morena1001/Midi-Controller/Documentation/Task Decomposition.md

## Task Decomposition

- [x] ~~Prototype on prototyping MCU~~
  - [x] ~~Setup IDE project for the prototyping MCU~~
    - [x] ~~GPIO input and ADC pins~~
    - [x] ~~USB pins~~
  - [x] ~~Setup push button layout on prototyping breadboard~~
  - [x] ~~Connect breadboard and components to the MCU~~
  - [x] ~~Setup USB connection using custom usb cable~~
  - [x] ~~Write code to transmit MIDI messages~~

- [x] ~~Prototype on final design MCU~~
  - [x] ~~Setup new IDE project using the final design MCU~~
  - [x] ~~Rewire breaboard and components to the final design MCU~~
  - [x] ~~Setup USB connection using Micro USB to USB A cable~~
  - [x] ~~Translate code to work with final design MCU~~

- [x] Design final product part 1
  - [x] Choose components for the project
    - [x] ~~push buttons~~
    - [x] ~~potentiometers~~
    - [ ] capacitors (breadboard and SMD)
    - [ ] LED (SMD) ? 
  - [x] Design PCB according to the size and pin specifications of all the components
    - [x] Send schematics to be printed by a 3rd party PCB printing company online
  - [x] Create rough sketch of the layout for the push buttons and potentiometers

- [x] Prototype on final design components
  - [x] Fix issues and bugs software side before testing the PCB (6 29 25)
  - [x] Rewire breadboard to test final design push buttons, potentiometers, and capacitor
  - [x] Solder final design push buttons, capacitors, potentiometers, and MCU to the 3rd party PCB
  - [x] Test to make sure PCB and components are working as should

- [ ] Design final product part 2
  - [x] Dimension the PCB and its will-be-visible components 
  - [x] Create rough sketch of case
  - [ ] Print the case
    - [x] First half is the top part with the holes for the push buttons, potentiometers, and Micro USB port
    - [x] Bottom half is a solid plate
    - [ ] Halves are connected via screws
    - [ ] Reiterate until dimensions are good

- [ ] Assemble final design
  - [ ] Attach PCB inside the case
  - [ ] Close the case and attach external components
    - [ ] Friction pad to prevent sliding
    - [ ] Clear plastic to view led ?

- [x] Final live test
  - [x] Do final test to make sure all works well
  - [x] Do a live test with entire setup at church
