morena1001/Midi-Controller/pcb/pcb.step

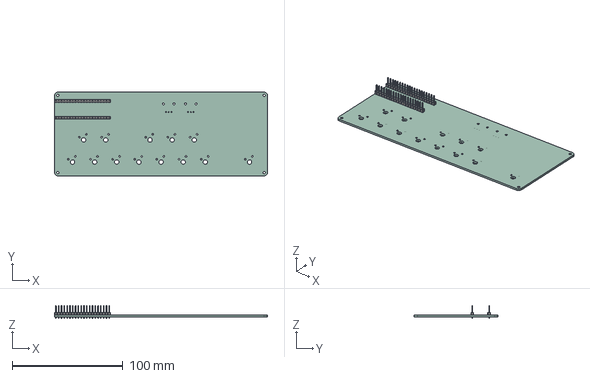
[picture p1: CAD file, 2025-06-20]
pcb/pcb.step
192.5 x 75.8 x 11.5 mm
PinHeader_1x20_P254mm_Vertical x 2
pcb_PCB
