morena1001/Midi-Controller/(list of files, cad)

Other CAD files:
pcb/pcb.3mf
