morena1001/Midi-Controller/pcb/pcb.kicad_pcb

## KiCad design pcb/pcb.kicad_pcb (2025-06-18)

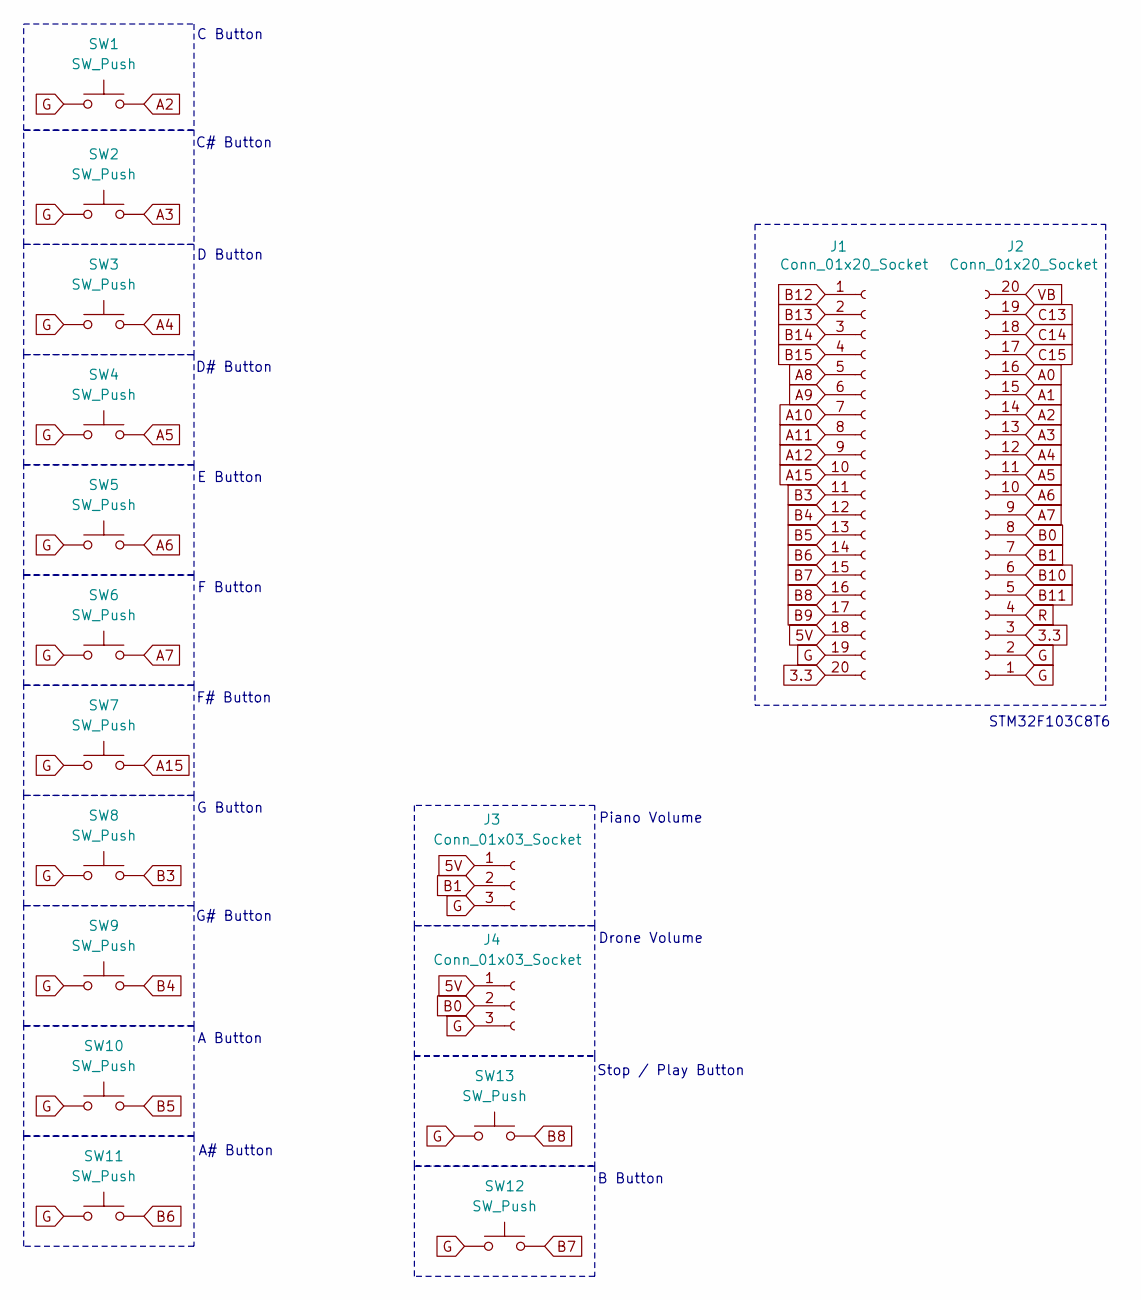
[picture p2: schematic pcb.kicad_sch]

Parts:
J1, J2: Conn_01x20_Socket; PinHeader_1x20_P2.54mm_Vertical
J3, J4: Conn_01x03_Socket; Potentiometer_Alpha_RD901F-40-00D_Single_Vertical_CircularH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
SW1, SW2, SW3, SW4, SW5, SW6, SW7, SW8, SW9, SW10, SW11, SW12, SW13: SW_Push; SW_Cherry_MX_1.00u_Plate

Connections:
3.3: J1.20, J2.3
5V: J1.18, J3.1, J4.1
A0: J2.16
A1: J2.15
A2: J2.14, SW1.2
A3: J2.13, SW2.2
A4: J2.12, SW3.2
A5: J2.11, SW4.2
A6: J2.10, SW5.2
A7: J2.9, SW6.2
A8: J1.5
A9: J1.6
A10: J1.7
A11: J1.8
A12: J1.9
A15: J1.10, SW7.2
B0: J2.8, J4.2
B1: J2.7, J3.2
B3: J1.11, SW8.2
B4: J1.12, SW9.2
B5: J1.13, SW10.2
B6: J1.14, SW11.2
B7: J1.15, SW12.2
B8: J1.16, SW13.2
B9: J1.17
B10: J2.6
B11: J2.5
B12: J1.1
B13: J1.2
B14: J1.3
B15: J1.4
C13: J2.19
C14: J2.18
C15: J2.17
G: J1.19, J2.1, J2.2, J3.3, J4.3, SW1.1, SW2.1, SW3.1, SW4.1, SW5.1, SW6.1, SW7.1, SW8.1, SW9.1, SW10.1, SW11.1, SW12.1, SW13.1
R: J2.4
VB: J2.20

Notes on the sheet:
G Button
B Button
Stop / Play Button
F Button
F# Button
C# Button
A# Button
C Button
Drone Volume
G# Button
D# Button
A Button
Piano Volume
D Button
STM32F103C8T6
E Button

Board: 2 copper layers, 17 parts (0 on the bottom side), 18 nets, no tracks yet.
