morena1001/Midi-Controller/Core/Src/main.c

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
/* Includes ------------------------------------------------------------------*/
#include "main.h"
#include "usb_device.h"

/* USER CODE BEGIN Includes */
#include "usbd_midi.h"
#include "queue.h"
/* USER CODE END Includes */

ADC_HandleTypeDef hadc1;
ADC_HandleTypeDef hadc2;

TIM_HandleTypeDef htim2;
TIM_HandleTypeDef htim3;

/* USER CODE BEGIN PV */
extern USBD_HandleTypeDef hUsbDeviceFS;

extern uint16_t D_previous;
extern uint16_t D_current;
extern uint16_t D_sum;

extern uint16_t P_previous;
extern uint16_t P_current;
extern uint16_t P_sum;

extern uint8_t D_vol_message [4];
extern uint8_t P_vol_message [4];
/* USER CODE END PV */

void SystemClock_Config(void);
static void MX_GPIO_Init(void);
static void MX_ADC1_Init(void);
static void MX_TIM2_Init(void);
static void MX_ADC2_Init(void);
static void MX_TIM3_Init(void);
/* USER CODE BEGIN PFP */
uint16_t ADC_Convert_Rank1 (void);
uint16_t ADC_Convert_Rank2 (void);
/* USER CODE END PFP */

/* USER CODE BEGIN 0 */
uint16_t ADC_Convert_Rank1 (void) {
	ADC_ChannelConfTypeDef sConfig = {0};

	sConfig.Channel = ADC_CHANNEL_8;
	sConfig.Rank = ADC_REGULAR_RANK_1;
	sConfig.SamplingTime = ADC_SAMPLETIME_1CYCLE_5;
	if (HAL_ADC_ConfigChannel(&hadc1, &sConfig) != HAL_OK)
	{
		Error_Handler();
	}

	HAL_ADC_Start (&hadc1);
	HAL_ADC_PollForConversion (&hadc1, 100);
	uint16_t val = HAL_ADC_GetValue (&hadc1);
	HAL_ADC_Stop (&hadc1);

	return val;
}

uint16_t ADC_Convert_Rank2 (void) {
	ADC_ChannelConfTypeDef sConfig = {0};

	sConfig.Channel = ADC_CHANNEL_9; // ADC_CHANNEL_0
 	sConfig.Rank = ADC_REGULAR_RANK_1;
	sConfig.SamplingTime = ADC_SAMPLETIME_1CYCLE_5;
	if (HAL_ADC_ConfigChannel(&hadc2 /*&hadc1*/, &sConfig) != HAL_OK)
	{
		Error_Handler();
	}

	HAL_ADC_Start (&hadc2 /*&hadc1*/);
	HAL_ADC_PollForConversion (&hadc2 /*&hadc1*/, 100);
	uint16_t val = HAL_ADC_GetValue (&hadc2 /*&hadc1*/);
	HAL_ADC_Stop (&hadc2 /*&hadc1*/);

	return val;
}
/* USER CODE END 0 */

/**
  * @brief  The application entry point.
  * @retval int
  */
int main(void)
{

  /* MCU Configuration--------------------------------------------------------*/

  /* Reset of all peripherals, Initializes the Flash interface and the Systick. */
  HAL_Init();

  /* Configure the system clock */
  SystemClock_Config();

  /* Initialize all configured peripherals */
  MX_GPIO_Init();
  MX_USB_DEVICE_Init();
  MX_ADC1_Init();
  MX_TIM2_Init();
  MX_ADC2_Init();
  MX_TIM3_Init();
  /* USER CODE BEGIN 2 */
  Queue_Init (DEFAULT_QUEUE_SIZE);

//	for (uint8_t i = 0; i < 16; i++)	D_sum += ADC_Convert_Rank1 ();
//
//	D_current = ((D_sum >> 4) * 127) / 4095;
//	D_sum = 0;
//
//	if (D_current < D_previous - 3 || D_current > D_previous + 3) {
//		D_previous = D_current;
//		D_vol_message [3] = D_current;
//
//	//		while (USBD_MIDI_GetState (&hUsbDeviceFS) != MIDI_IDLE) {}
//		USBD_MIDI_SendPackets (&hUsbDeviceFS, D_vol_message, 4);
//	//		Enqueue (D_vol_message);
//	}
//
//	for (uint8_t i = 0; i < 16; i++)	P_sum += ADC_Convert_Rank2 ();
//
//	P_current = ((P_sum >> 4) * 127) / 4095;
//	P_sum = 0;
//
//	if (P_current < P_previous - 3 || P_current > P_previous + 3) {
//		P_previous = P_current;
//		D_vol_message [3] = P_current;
//
//	//		while (USBD_MIDI_GetState (&hUsbDeviceFS) != MIDI_IDLE) {}
//		USBD_MIDI_SendPackets (&hUsbDeviceFS, P_vol_message, 4);
//	//		Enqueue (P_vol_message);
//	}

  HAL_NVIC_SetPriority (TIM2_IRQn, 0, 0);
  HAL_NVIC_EnableIRQ (TIM2_IRQn);
  HAL_TIM_Base_Start_IT (&htim2);

  HAL_NVIC_SetPriority (TIM3_IRQn , 0, 0);
  HAL_NVIC_EnableIRQ (TIM3_IRQn );
  HAL_TIM_Base_Start_IT (&htim3);
  /* USER CODE END 2 */

  /* Infinite loop */
  /* USER CODE BEGIN WHILE */
  while (1)
  {
    /* USER CODE END WHILE */

    /* USER CODE BEGIN 3 */
  }
  Queue_Deinit ();
  /* USER CODE END 3 */
}

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
