morena1001/Midi-Controller/Blue Pill Midi Controller.ioc

Mcu.UserName=STM32F103C8Tx
PA11.Signal=USB_DM
PA12.Signal=USB_DP
PA13.Signal=SYS_JTMS-SWDIO
PA14.Signal=SYS_JTCK-SWCLK
PA15.GPIO_Label=FS_B [F\# Button]
PA15.Signal=GPIO_Input
PA2.GPIO_Label=C_B [C Button]
PA2.Signal=GPIO_Input
PA3.GPIO_Label=CS_B [C\# Button]
PA3.Signal=GPIO_Input
PA4.GPIO_Label=D_B [D Button]
PA4.Signal=GPIO_Input
PA5.GPIO_Label=DS_B [D\# Button]
PA5.Signal=GPIO_Input
PA6.GPIO_Label=E_B [E Button]
PA6.Signal=GPIO_Input
PA7.GPIO_Label=F_B [F Button]
PA7.Signal=GPIO_Input
PB0.GPIO_Label=D_V [Drone Volume]
PB0.Signal=ADCx_IN8
PB1.GPIO_Label=P_V [Piano Volume]
PB1.Signal=ADCx_IN9
PB3.GPIO_Label=G_B [G Button]
PB3.Signal=GPIO_Input
PB4.GPIO_Label=GS_B [G\# Button]
PB4.Signal=GPIO_Input
PB5.GPIO_Label=A_B [A Button]
PB5.Signal=GPIO_Input
PB6.GPIO_Label=AS_B [A Button]
PB6.Signal=GPIO_Input
PB7.GPIO_Label=B_B [B Button]
PB7.Signal=GPIO_Input
PB8.GPIO_Label=SP_B [Stop / Play Button]
PB8.Signal=GPIO_Input
PD0-OSC_IN.Signal=RCC_OSC_IN
PD1-OSC_OUT.Signal=RCC_OSC_OUT
