morena1001/Midi-Controller/(commit log)

2025-01-30 Can send out messages that are hopefully MIDI compliant or in correct MIDI format.
    [main.c, main.h]
2025-06-02 Found a MIDI library on Github by Hypnotriod and Pieter12345, and proved very successful for my project. I was finally able to implement the basic MIDI controller that controlled the drone key and po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
2025-06-05 Added potentiometer feature, and connecting it to a slider on MainStage, let me control the volume. The only issue is the power supplies fluctuations. Aparently a capacitor connected from the ADC to 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
    [main.c, main.h]
2025-06-08 Switched project over from the STM32F302R8 MCU to the STM32F103C8T6 MCU, also known as the blue pill. The final design use the blue pill for the reason that it is way more tiny than the first MCU. Ne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
2025-06-11 Update Task Decomposition.md
    Task decomposition now shows current project progress
2025-06-13 Finished schematic for the pcb. Next is to create layout of pcb
    [pcb.kicad_pcb, pcb.kicad_sch]
2025-06-18 I accidentally set up the project using the wrong folder, so I hope this fixes it. All these new files are the real project. Anyway, fixed issues with ADC breaking the MIDI connection. Small crash wh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
    [pcb.kicad_pcb, pcb.kicad_sch]
2025-06-20 Finished PCB, needs hole testing to make sure components fit, and can then be sent to be manufactured
    [Vandar Midi Controller BOM.csv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]
2025-06-29 Update task decomposition and added week 3 and 4 progress reports
    [pcb.3mf]
2025-07-02 Half finished. The queue works fine for the buttons, but there is an issue trying to enqueue the P_vol_message array. The D_vol_message works fine, which makes this all the more weirder.
    [Blue Pill Midi Controller.ioc, main.c]
2025-07-03 Finished feature. Code may or may not work without queue feature. Will need to test that.
    [Blue Pill Midi Controller.ioc, main.c]
2025-07-07 Added functionality for both potentiometers, with no more crashes.
    [Blue Pill Midi Controller.ioc, main.c]
